maxschommer/robo_board/CombatBoard/Board BOM.xlsx

Component | Description | Part | References | Value | Digikey P/N | Quantity Per PCB | Cost | Line Cost
1 | Reset Button | button | BTN1 | CKN10291CT-ND | CKN10291CT-ND | 1 | 0.3 | 0.3
2 | Unpolarized capacitor , .1uf | C | C6 C7 C9 C10 | .1uF | 445-5667-1-ND | 4 | 0.1 | 0.4 | 311-1779-1-ND
3 | Unpolarized capacitor, 10pf | C | C1 C2 | 10pF | 490-9682-1-ND | 2 | 0.15 | 0.3
4 | Unpolarized capacitor, 10uf | C | C8 C11 C12 | 10uF | 445-5667-1-ND | 3 | 0.28 | 0.84 | 1276-2872-1-ND
5 | Unpolarized capacitor, 1uf | C | C3 C5 C13 C14 C15 C16 | 1uF | 399-7376-1-ND | 6 | 0.24 | 1.44
6 | Unpolarized capacitor,16v 4.7uf | C | C4 | 4.7uF, 16V | 587-4877-1-ND | 1 | 0.34 | 0.34
7 | BLDC Pin Header | Conn_01x03 | J4 | CONN_01X03 | S5674-ND | 1 | 1.14 | 1.14
8 | Radio Pin HEader | Conn_02x04_Counter_Clockwise-RESCUE-breakout_board | J3 | CONN_02x04 | ----- | 1 | 0 | 0
9 | ICSP Pin Header | Conn_02x03_Odd_Even | J5 | Conn_02x03_Odd_Even | ------ | 1 | 0 | 0
10 | LED generic | LED | LED3 | BLUE | 160-1579-1-ND | 1 | 0.43 | 0.43
11 | LED generic | LED | LED2 | GREEN | 160-1887-1-ND | 1 | 0.65 | 0.65
12 | LED generic | LED | LED1 | RED | 160-1427-1-ND | 1 | 0.31 | 0.31
13 | 16MHZ Oscillator | Crystal_GND24 | OS1 | 16MHZ | XC2119CT-ND | 1 | 0.74 | 0.74
14 | Resistor 10K | R | R1 | 10K | 311-10.0KHRCT-ND | 1 | 0.1 | 0.1
15 | Resistor 499ohm | R | R2 R3 R4 | 499 | 311-499HRCT-ND | 3 | 0.1 | 0.3
16 | 5V Regulator | ADP3330 | U3 | ADP3330 | ADP3330ARTZ-5-RL7CT-ND | 1 | 2.64 | 2.64
17 | Logic Chip | ATMEGA328P-MUR | U1 | ATMEGA328P-MUR | ATMEGA328P-MURCT-ND | 1 | 2.2 | 2.2
18 | 3V3 Regulator | LP5907SNX-3.3/NOPB | U4 | LP5907SNX-3.3/NOPB | 296-39066-1-ND | 1 | 0.55 | 0.55
19 | Brushed Motor Driver | TB6612FNG | U2 | TB6612FNG | TB6612FNGC8ELCT-ND | 1 | $2.11 | $2.11
 |  |  |  |  |  |  | 14.79
