maxschommer/robo_board/CombatBoard/Custom Libraries/MAX7375 STL/STEP/21-0075C-M.step

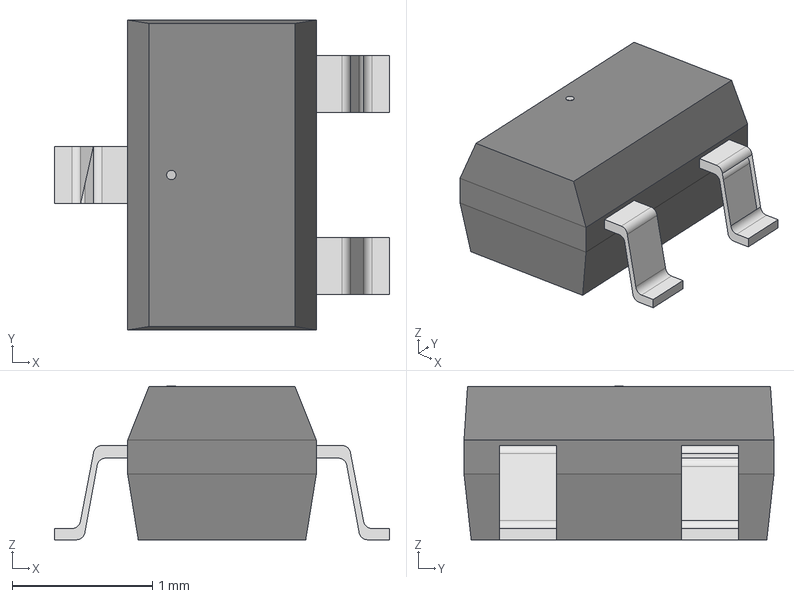
[picture p1: CAD file, 2017-10-01]
CombatBoard/Custom Libraries/MAX7375 STL/STEP/21-0075C-M.step
2.39 x 2.21 x 1.09 mm
