maxschommer/robo_board/(list of files, cad)

Other CAD files:
CombatBoard/Custom Libraries/MAX7375 STL/STEP/21-0075C.step
ControlBoard/Custom Libraries/MAX7375 STL/STEP/21-0075C-L.step
CombatBoard/Custom Libraries/MAX7375 STL/STEP/21-0075C-L.step
ControlBoard/Custom Libraries/MAX7375 STL/STEP/21-0075C.step
