maxschommer/robo_board/breakout_board/ROBO_BOARD_R1.pdf

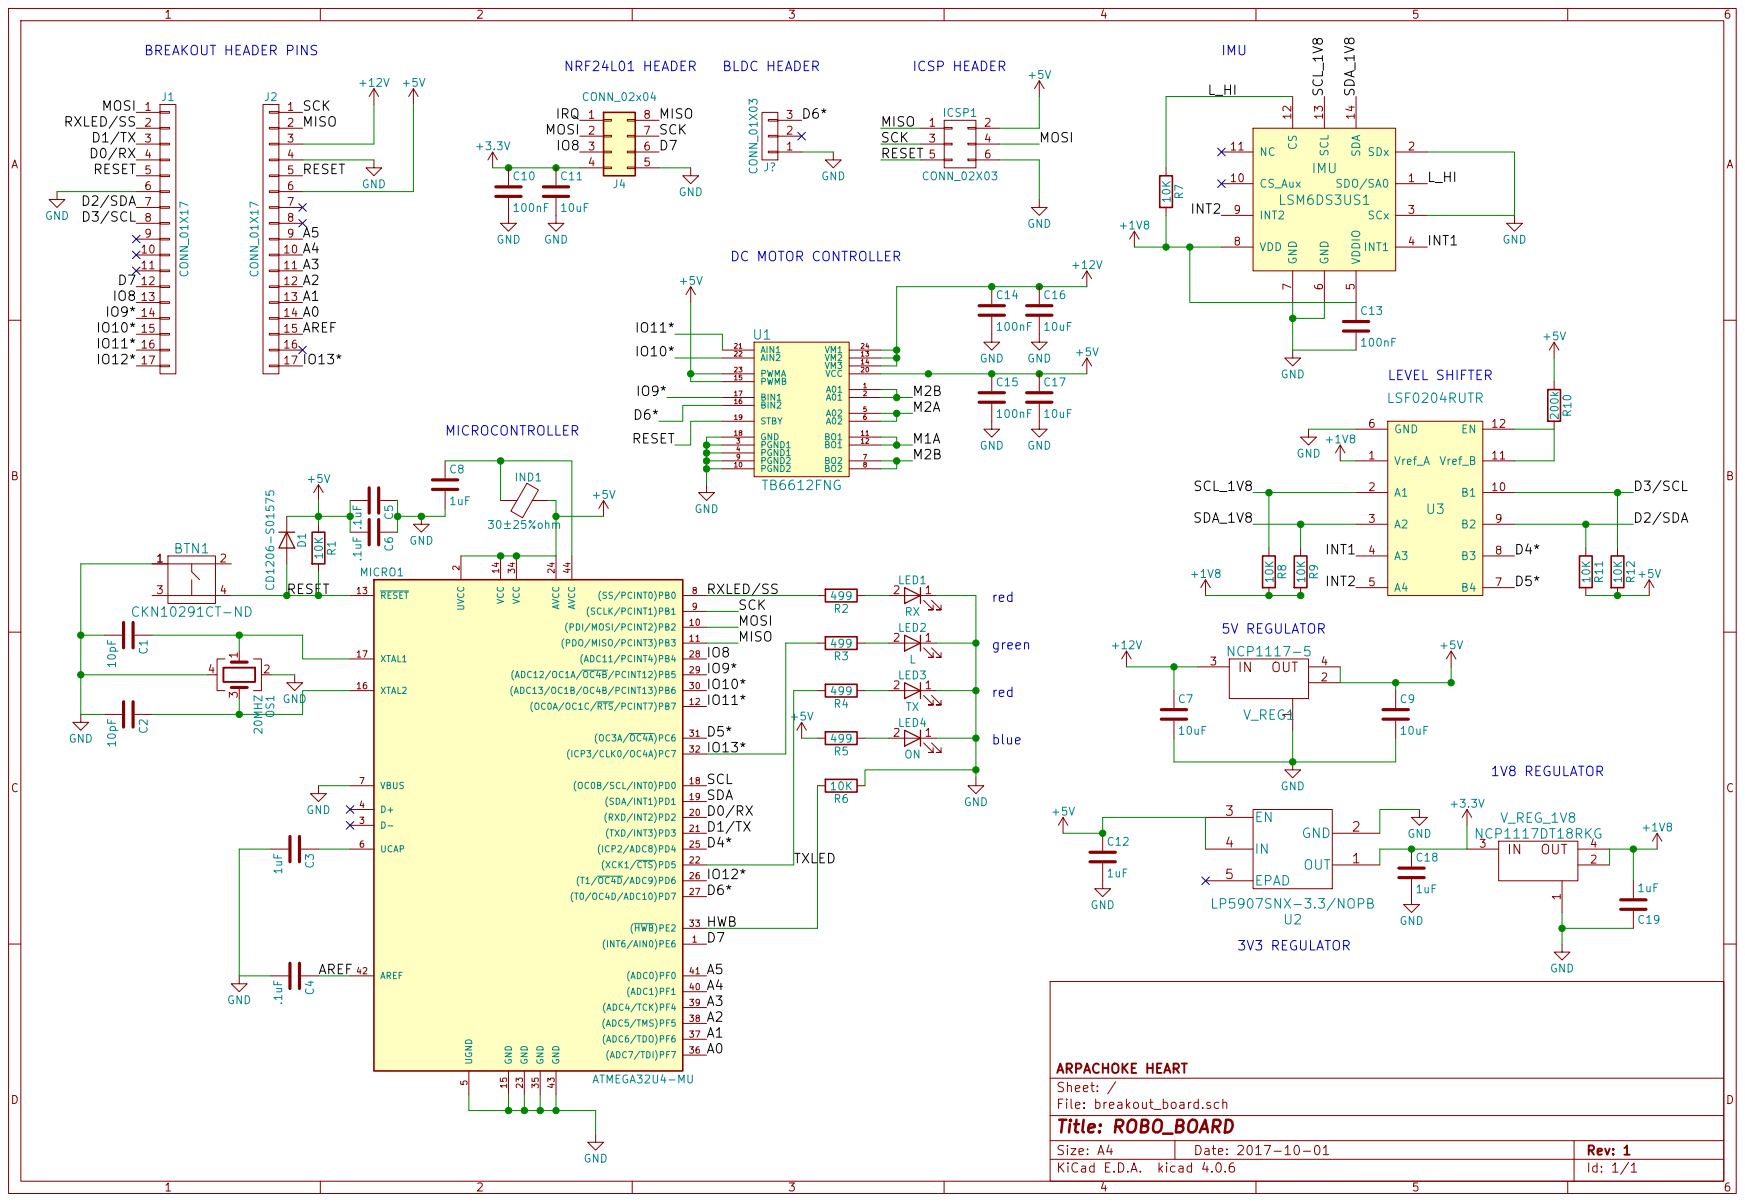
[picture p2: page 1]
