maxschommer/robo_board/(list of files, drawings)

Other design files:
Altium_Redesign/Altium Library/32U4.SchLib
Altium_Redesign/Altium Library/PcbLib1.PcbLib
Altium_Redesign/Altium Library/Project Outputs for Robo_Board_Library/Robo_Board_Library1/32U4.SchLib
Altium_Redesign/Altium Library/Project Outputs for Robo_Board_Library/Robo_Board_Library1/PcbLib1.PcbLib
Altium_Redesign/Altium Library/Project Outputs for Robo_Board_Library/Robo_Board_Library2/32U4.SchLib
Altium_Redesign/Altium Library/Project Outputs for Robo_Board_Library/Robo_Board_Library2/PcbLib1.PcbLib
Altium_Redesign/Altium Library/Project Outputs for Robo_Board_Library/Robo_Board_Library/32U4.SchLib
Altium_Redesign/Altium Library/Project Outputs for Robo_Board_Library/Robo_Board_Library/PcbLib1.PcbLib
Altium_Redesign/Arduino.SchDoc
Altium_Redesign/Main.SchDoc
Altium_Redesign/RoboBoardv2.PrjPCB
Altium_Redesign/SnapEDA component/MH2029-300Y/Imported SMD-FERRITE-BEAD-30R-3A_0805_.lia/Project Outputs for SMD-FERRITE-BEAD-30R-3A_0805_/SMD-FERRITE-BEAD-30R-3A_0805_/SMD-FERRITE-BEAD-30R-3A_0805_.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
Altium_Redesign/SnapEDA component/MH2029-300Y/Imported SMD-FERRITE-BEAD-30R-3A_0805_.lia/Project Outputs for SMD-FERRITE-BEAD-30R-3A_0805_/SMD-FERRITE-BEAD-30R-3A_0805_/SMD-FERRITE-BEAD-30R-3A_0805_.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
Altium_Redesign/SnapEDA component/MH2029-300Y/Imported SMD-FERRITE-BEAD-30R-3A_0805_.lia/SMD-FERRITE-BEAD-30R-3A_0805_.PcbLib
Altium_Redesign/SnapEDA component/MH2029-300Y/Imported SMD-FERRITE-BEAD-30R-3A_0805_.lia/SMD-FERRITE-BEAD-30R-3A_0805_.SchLib
Altium_Redesign/Temp_Libraries/Atmel Microcontroller 8-Bit megaAVR/Atmel Microcontroller 8-Bit megaAVR.PcbLib
Altium_Redesign/Temp_Libraries/TB6612FNG_C_8_EL1/TB6612FNG_C_8_EL.PcbLib
Altium_Redesign/Temp_Libraries/TB6612FNG_C_8_EL1/TB6612FNG_C_8_EL.SchLib
Altium_Redesign/Temp_Libraries/TB6612FNG_C_8_EL/TB6612FNG_C_8_EL.PcbLib
Altium_Redesign/Temp_Libraries/TB6612FNG_C_8_EL/TB6612FNG_C_8_EL.SchLib
CombatBoard/breakout_board2.dsn
ControlBoard/breakout_board2.dsn
