maxschommer/robo_board/CombatBoard/breakout_board2.kicad_pcb

## KiCad design CombatBoard/breakout_board2.kicad_pcb (2018-01-31)

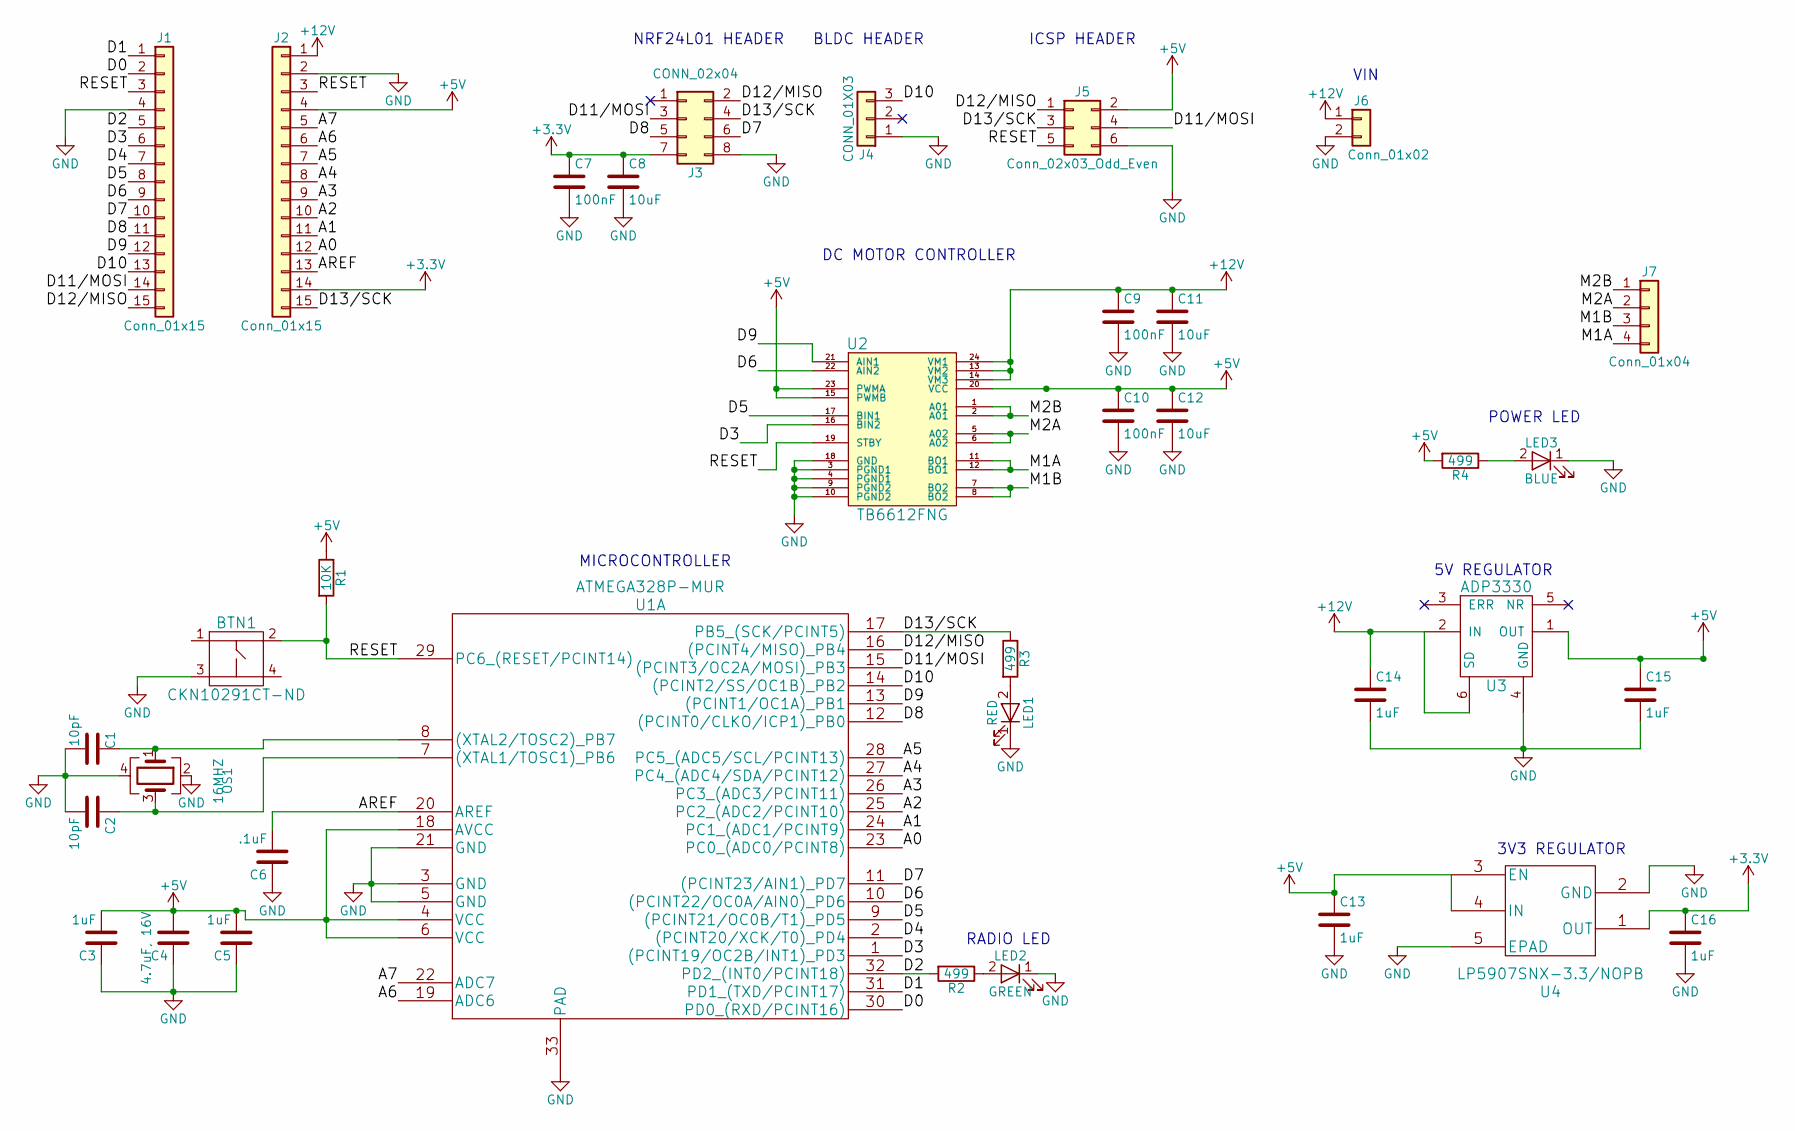
[picture p3: schematic breakout_board2.sch, ROBO_BOARD]

Parts:
BTN1: CKN10291CT-ND; KMT071_NGJ_LHS
C1, C2: 10pF; C_0603
C3, C5, C13, C14, C15, C16: 1uF; C_0603
C4: 4.7uF, 16V; C_0805
C6: .1uF; C_0603
C7, C9, C10: 100nF; C_0603
C8, C11, C12: 10uF; C_0805
J1, J2: Conn_01x15; Pin_Header_Straight_1x15_Pitch2.54mm
J3: CONN_02x04; Pin_Header_Straight_2x04_Pitch2.54mm_SMD
J4: CONN_01X03; Pin_Header_Straight_1x03_Pitch2.54mm
J5: Conn_02x03_Odd_Even; Pin_Header_Straight_2x03_Pitch2.54mm
J6: Conn_01x02; Pin_Header_Straight_1x02_Pitch2.54mm
J7: Conn_01x04; Pin_Header_Straight_1x04_Pitch2.54mm
LED1: RED; LED_0805
LED2: GREEN; LED_0805
LED3: BLUE; LED_0805
OS1: 16MHZ; XC2119CT
R1: 10K; R_0603
R2, R3, R4: 499; R_0603
U1: ATMEGA328P-MUR; QFN-32-1EP_5x5mm_Pitch0.5mm
U2: TB6612FNG; SOP65P760X160-24N
U3: ADP3330; SOT-23-6
U4: LP5907SNX-3.3/NOPB; DQN4

Connections:
+3V3: C7.1, C8.1, C16.1, J2.14, J3.7 (Pin_4), U4.1 (OUT)
+5V: C3.2, C4.2, C5.2, C10.1, C12.1, C13.1, C15.1, J2.4, J5.2, R1.1, R4.2, U1.4 (VCC), U1.6 (VCC), U1.18 (AVCC), U2.15 (PWMB), U2.20 (VCC), U2.23 (PWMA), U3.1 (OUT), U4.3 (EN), U4.4 (IN)
+12V: C9.1, C11.1, C14.1, J2.1, J6.1, U2.13 (VM2), U2.14 (VM3), U2.24 (VM1), U3.2 (IN), U3.6 (SD)
/A0: J2.12, U1.23 (PC0_(ADC0/PCINT8))
/A1: J2.11, U1.24 (PC1_(ADC1/PCINT9))
/A2: J2.10, U1.25 (PC2_(ADC2/PCINT10))
/A3: J2.9, U1.26 (PC3_(ADC3/PCINT11))
/A4: J2.8, U1.27 (PC4_(ADC4/SDA/PCINT12))
/A5: J2.7, U1.28 (PC5_(ADC5/SCL/PCINT13))
/A6: J2.6, U1.19 (ADC6)
/A7: J2.5, U1.22 (ADC7)
/AREF: C6.2, J2.13, U1.20 (AREF)
/D0: J1.2, U1.30 (PD0_(RXD/PCINT16))
/D1: J1.1, U1.31 (PD1_(TXD/PCINT17))
/D2: J1.5, R2.2, U1.32 (PD2_(INT0/PCINT18))
/D3: J1.6, U1.1 ((PCINT19/OC2B/INT1)_PD3), U2.16 (BIN2)
/D4: J1.7, U1.2 ((PCINT20/XCK/T0)_PD4)
/D5: J1.8, U1.9 ((PCINT21/OC0B/T1)_PD5), U2.17 (BIN1)
/D6: J1.9, U1.10 ((PCINT22/OC0A/AIN0)_PD6), U2.22 (AIN2)
/D7: J1.10, J3.6, U1.11 ((PCINT23/AIN1)_PD7)
/D8: J1.11, J3.5 (Pin_3), U1.12 ((PCINT0/CLKO/ICP1)_PB0)
/D9: J1.12, U1.13 ((PCINT1/OC1A)_PB1), U2.21 (AIN1)
/D10: J1.13, J4.3, U1.14 ((PCINT2/SS/OC1B)_PB2)
/D11/MOSI: J1.14, J3.3 (Pin_2), J5.4, U1.15 ((PCINT3/OC2A/MOSI)_PB3)
/D12/MISO: J1.15, J3.2 (Pin_8), J5.1, U1.16 ((PCINT4/MISO)_PB4)
/D13/SCK: J2.15, J3.4 (Pin_7), J5.3, R3.1, U1.17 (PB5_(SCK/PCINT5))
/M1A: J7.4, U2.11 (BO1), U2.12 (BO1)
/M1B: J7.3, U2.7 (BO2), U2.8 (BO2)
/M2A: J7.2, U2.5 (A02), U2.6 (A02)
/M2B: J7.1, U2.1 (A01), U2.2 (A01)
/RESET: BTN1.2, J1.3, J2.3, J5.5, R1.2, U1.29 (PC6_(RESET/PCINT14)), U2.19 (STBY)
GND: BTN1.3, C1.2, C2.2, C3.1, C4.1, C5.1, C6.1, C7.2, C8.2, C9.2, C10.2, C11.2, C12.2, C13.2, C14.2, C15.2, C16.2, J1.4, J2.2, J3.8 (Pin_5), J4.1, J5.6, J6.2, LED1.1 (K), LED2.1 (K), LED3.1 (K), OS1.2, OS1.4, U1.3 (GND), U1.5 (GND), U1.21 (GND), U1.33 (PAD), U2.3 (PGND1), U2.4 (PGND1), U2.9 (PGND2), U2.10 (PGND2), U2.18 (GND), U3.4 (GND), U4.2 (GND), U4.5 (EPAD)
unnamed: C1.1, OS1.1, U1.8 ((XTAL2/TOSC2)_PB7)
unnamed: C2.1, OS1.3, U1.7 ((XTAL1/TOSC1)_PB6)
unnamed: LED1.2 (A), R3.2
unnamed: LED2.2 (A), R2.1
unnamed: LED3.2 (A), R4.1

Notes on the sheet:
BLDC HEADER
NRF24L01 HEADER
ICSP HEADER
5V REGULATOR
3V3 REGULATOR
DC MOTOR CONTROLLER
MICROCONTROLLER
VIN
POWER LED
RADIO LED

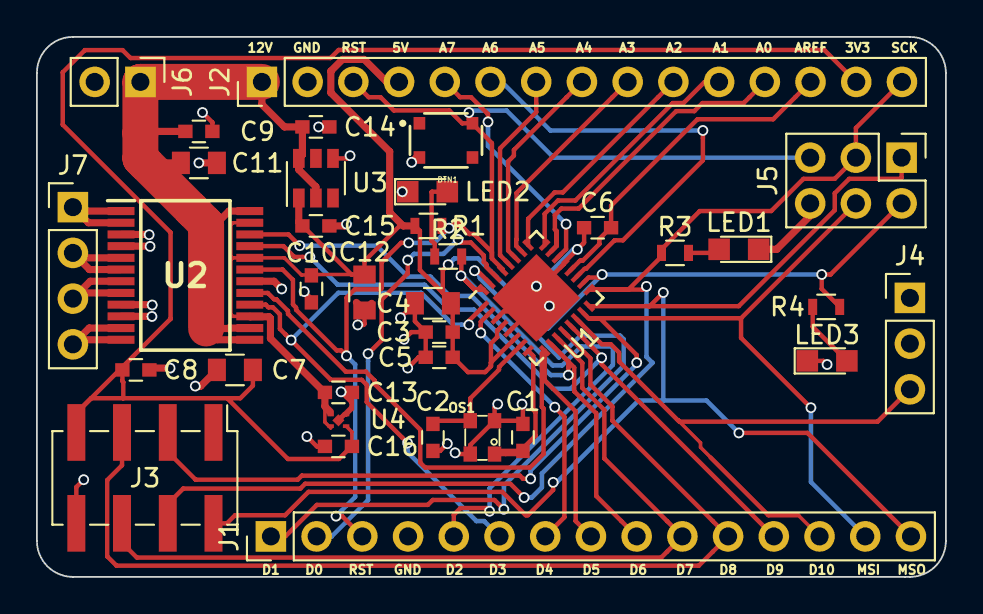
[picture p4: board breakout_board2.kicad_pcb from above]

Board: 2 copper layers, 50.5 x 30.0 mm, 36 parts (0 on the bottom side), 37 nets.
