maxschommer/robo_board/breakout_board/breakout_board.kicad_pcb

## KiCad design breakout_board/breakout_board.kicad_pcb (2018-01-25)

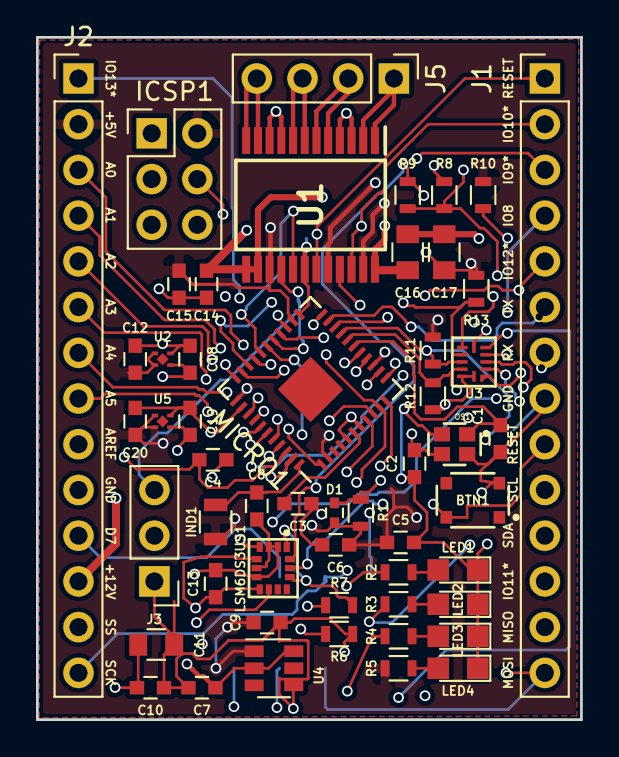
[picture p5: board breakout_board.kicad_pcb from above]

Board: 4 copper layers, 30.2 x 37.9 mm, 54 parts (1 on the bottom side), 50 nets.

Parts:
BTN1: CKN10291CT-ND; KMT071_NGJ_LHS
C1, C2: 10pF; C_0603
C3, C7, C8, C9, C12, C18, C19, C20: 1uF; C_0603
C4, C5, C6: .1uF; C_0603
C10, C13, C14, C15: 100nF; C_0603
C11, C16, C17: 10uF; C_0805
D1: CD1206-S01575; C_0402
ICSP1: CONN_02X03; Pin_Header_Straight_2x03_Pitch2.54mm
IND1: 30±25%ohm; L_0805
J1, J2: Conn_01x14; Pin_Header_Straight_1x14_Pitch2.54mm
J3: CONN_01X03; Pin_Header_Straight_1x03_Pitch2.54mm
J4: CONN_02x04; Pin_Header_Straight_2x04_Pitch2.54mm_SMD
J5: Conn_01x04; Pin_Header_Straight_1x04_Pitch2.54mm
LED1: RX; LED_0805
LED2: L; LED_0805
LED3: TX; LED_0805
LED4: ON; LED_0805
LSM6DS3US1: IMU; LGA-14L
MICRO1: ATMEGA32U4-MU; QFN-44-1EP_7x7mm_Pitch0.5mm_M
OS1: 20MHZ; ABM11AIG
R1, R6, R7, R8, R9, R10, R11, R12, R13: 10K; R_0603
R2, R3, R4, R5: 499; R_0603
U1: TB6612FNG; SOP65P760X160-24N
U2: LP5907SNX-3.3/NOPB; DQN4
U3: LSF0204RUTR; R-PUQFN-N12
U4: ADP3330; SOT-23-6
U5: TLV70718PDQNR; DQN4

Connections:
+1V8: C13.1, C19.2, LSM6DS3US1.5, LSM6DS3US1.8, R7.2, R8.2, R9.2, U3.1, U5.1
+3V3: C10.1, C11.1, C18.1, J4.7, U2.1
+5V: C5.2, C6.2, C9.1, C12.1, C15.1, C17.1, C20.1, D1.1, ICSP1.2, IND1.1, J2.2, MICRO1.2, MICRO1.14, MICRO1.24, MICRO1.34, R1.1, R5.2, R10.2, R11.2, R12.2, R13.2, U1.15, U1.20, U1.23, U2.3, U2.4, U3.11, U3.12, U4.1, U5.3, U5.4
+12V: C7.1, C14.1, C16.1, J2.12, U1.13, U1.14, U1.24, U4.2, U4.6
/A0: J2.3, MICRO1.36
/A1: J2.4, MICRO1.37
/A2: J2.5, MICRO1.38
/A3: J2.6, MICRO1.39
/A4: J2.7, MICRO1.40
/A5: J2.8, MICRO1.41
/AREF: C4.1, J2.9, MICRO1.42
/D0/RX: J1.7, MICRO1.20
/D1/TX: J1.6, MICRO1.21
/D2/SDA: J1.11, MICRO1.19, R11.1, U3.9
/D3/SCL: J1.10, MICRO1.18, R12.1, U3.10
/D4*: MICRO1.25, R13.1, U3.8
/D5*: MICRO1.31, R10.1, U3.7
/D6*: J3.3, MICRO1.27, U1.16
/D7: J2.11, J4.6, MICRO1.1
/HWB: MICRO1.33, R6.2
/INT1: LSM6DS3US1.4, U3.4
/INT2: LSM6DS3US1.9, U3.5
/IO8: J1.4, J4.5, MICRO1.28
/IO9*: J1.3, MICRO1.29, U1.17
/IO10*: J1.2, MICRO1.30, U1.22
/IO11*: J1.12, MICRO1.12, U1.21
/IO12*: J1.5, MICRO1.26
/IO13*: J2.1, MICRO1.32, R3.2
/L_HI: LSM6DS3US1.1, LSM6DS3US1.12, R7.1
/M1A: J5.4, U1.11, U1.12
/M1B: J5.3, U1.7, U1.8
/M2A: J5.2, U1.5, U1.6
/M2B: J5.1, U1.1, U1.2
/MISO: ICSP1.1, J1.13, J4.2, MICRO1.11
/MOSI: ICSP1.4, J1.14, J4.3, MICRO1.10
/RESET: BTN1.2, D1.2, ICSP1.5, J1.1, J1.9, MICRO1.13, R1.2, U1.19
/RXLED/SS: J2.13, MICRO1.8, R2.2
/SCK: ICSP1.3, J2.14, J4.4, MICRO1.9
/SCL_1V8: LSM6DS3US1.13, R8.1, U3.2
/SDA_1V8: LSM6DS3US1.14, R9.1, U3.3
/TXLED: MICRO1.22, R4.2
GND: BTN1.3, C1.2, C2.2, C3.2, C4.2, C5.1, C6.1, C7.2, C8.2, C9.2, C10.2, C11.2, C12.2, C13.2, C14.2, C15.2, C16.2, C17.2, C18.2, C19.1, C20.2, ICSP1.6, J1.8, J2.10, J3.1, J4.8, LED1.1, LED2.1, LED3.1, LED4.1, LSM6DS3US1.2, LSM6DS3US1.3, LSM6DS3US1.6, LSM6DS3US1.7, MICRO1.5, MICRO1.7, MICRO1.15, MICRO1.23, MICRO1.35, MICRO1.43, OS1.2, OS1.4, R6.1, U1.3, U1.4, U1.9, U1.10, U1.18, U2.2, U3.6, U4.4, U5.2
unnamed: C1.1, MICRO1.17, OS1.1
unnamed: C2.1, MICRO1.16, OS1.3
unnamed: C3.1, MICRO1.6
unnamed: C8.1, IND1.2, MICRO1.44
unnamed: LED1.2, R2.1
unnamed: LED2.2, R3.1
unnamed: LED3.2, R4.1
unnamed: LED4.2, R5.1
