maxschommer/robo_board/(commit log)

2017-09-28 Adding atmega partial schematic
    [breakout_board.kicad_pcb, breakout_board.sch]
2017-09-28 Added some capacitors
    [breakout_board.sch]
2017-09-30 Added IMU
    [breakout_board.sch]
2017-10-01 Added brushed motor driver and headers
    [21-0075C-L.step, 21-0075C-M.step, 21-0075C.step, BLDC_CONTROLLER.sch, breakout_board.sch]
2017-10-01 Fixed trash labeling and remade ugly garbage while changing capacitors and resistors to be correct
    [breakout_board.sch]
2017-10-01 Added submission files
    [breakout_board.sch]
2017-10-05 Made changes from Brad
    [breakout_board.sch]
2017-10-10 Made some footprints
    [breakout_board.sch]
2017-10-10 Footprinting done - needs checking.
    [breakout_board.kicad_pcb, breakout_board.sch]
2017-10-11 More done
    [breakout_board.kicad_pcb, breakout_board.sch]
2017-10-11 worked some more
    [breakout_board.kicad_pcb]
2017-10-12 Changed components, routed a bunch of stuff
    [_saved_breakout_board.sch, breakout_board.kicad_pcb]
2017-10-13 Finished the board layout
    [breakout_board.kicad_pcb]
2017-10-13 Finished foreal
    [_saved_breakout_board.sch, breakout_board.sch]
2017-11-27 Fixed board
    [_saved_breakout_board.sch, breakout_board.kicad_pcb, breakout_board.sch]
2017-11-27 did DRC
    [breakout_board.kicad_pcb]
2018-01-15 started altium redesign
    How to edit the title block tho? Nobody knows.
    [Main.SchDoc, RoboBoardv2.PrjPCB]
2018-01-15 started sourcing/adding components
    snapeda is saving my liiife
    [Main.SchDoc, SMD-FERRITE-BEAD-30R-3A_0805_.PcbLib, SMD-FERRITE-BEAD-30R-3A_0805_.SchLib]
2018-01-24 redesign in work
    library management pending
    [2.SchDoc, 32U4.SchLib, 32U4.csv, Main.SchDoc, PcbLib1.PcbLib, RoboBoardv2.PrjPCB]
2018-01-25 made kicad v2
    ditched altium due to poor generic component libraries (depends heavily
    on vault), doing a 2-layer layout.
    [2.SchDoc, 21-0075C-L.step, 21-0075C-M.step, 21-0075C.step, 32U4.SchLib, Arduino.SchDoc, Atmel Microcontroller 8-Bit megaAVR.PcbLib, BLDC_CONTROLLER.sch]
2018-01-27 Finished board v2
    [Board BOM.xlsx, breakout_board2.dsn, breakout_board2.kicad_pcb, breakout_board2_bom_1.csv]
2018-01-31 minot updates
    [21-0075C-L.step, 21-0075C-M.step, 21-0075C.step, BLDC_CONTROLLER.sch, Board BOM.xlsx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]
